jisaac2021/IOPTIS-Laser-Controller-Circuit/README.md

## IOPTIS NEW GEN Laser Controller Circuit

## **PCB Layout 3D View**

**Front**

**Back**



## **Multi-sheet Schematic Layout**



## **Team**
Julia Isaac - Machine Learning & Software Intern

Loic Billaut - Electrical & Optical Engineering Intern
