jisaac2021/IOPTIS-Laser-Controller-Circuit/laser.kicad_pcb

## KiCad design laser.kicad_pcb (2021-09-15)

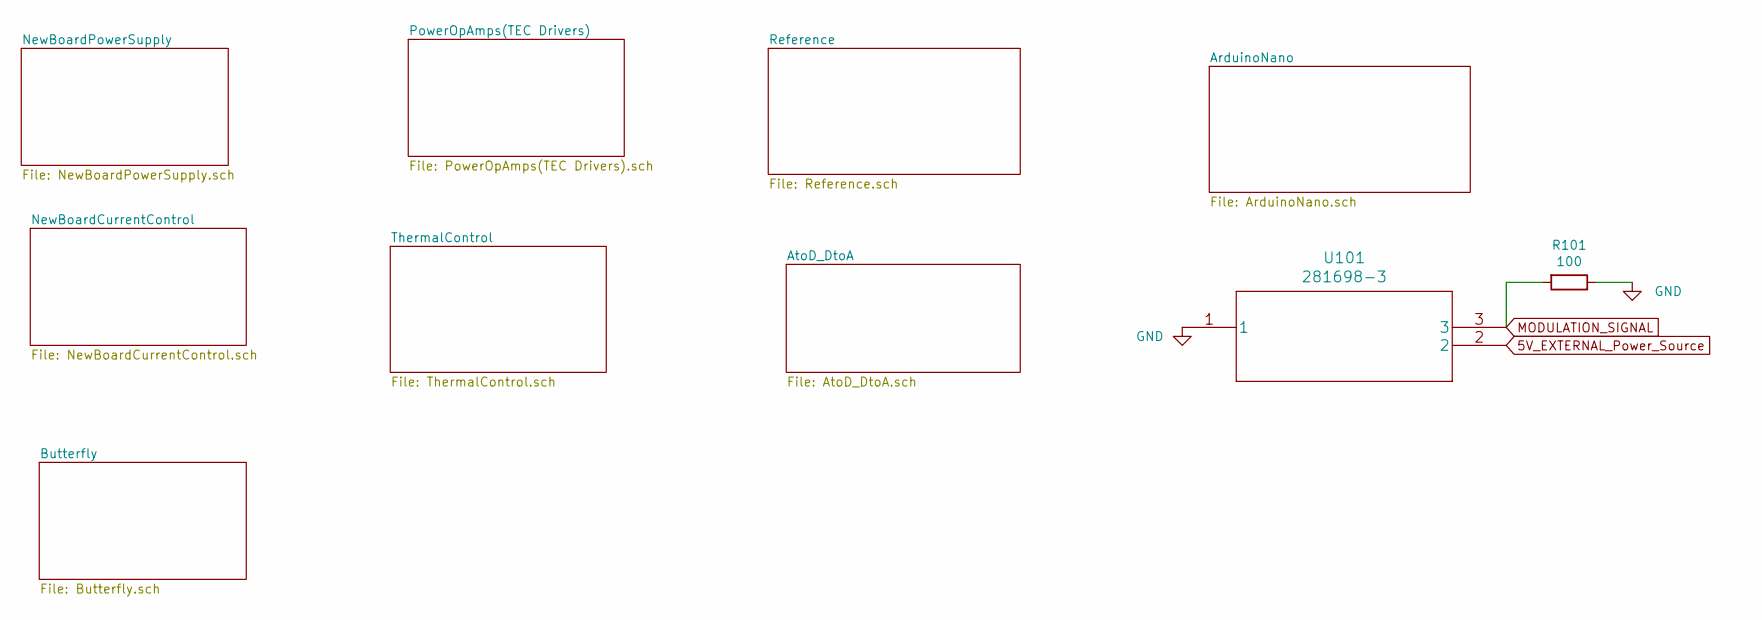
[picture p1: schematic laser.sch]

Parts:
R101: 100; R_0402_1005Metric
U101: 281698-3

Connections:
5V_EXTERNAL_Power_Source: U101.2; also elsewhere on the board
GND: R101.1, U101.1; also elsewhere on the board
MODULATION_SIGNAL: R101.2, U101.3; also elsewhere on the board

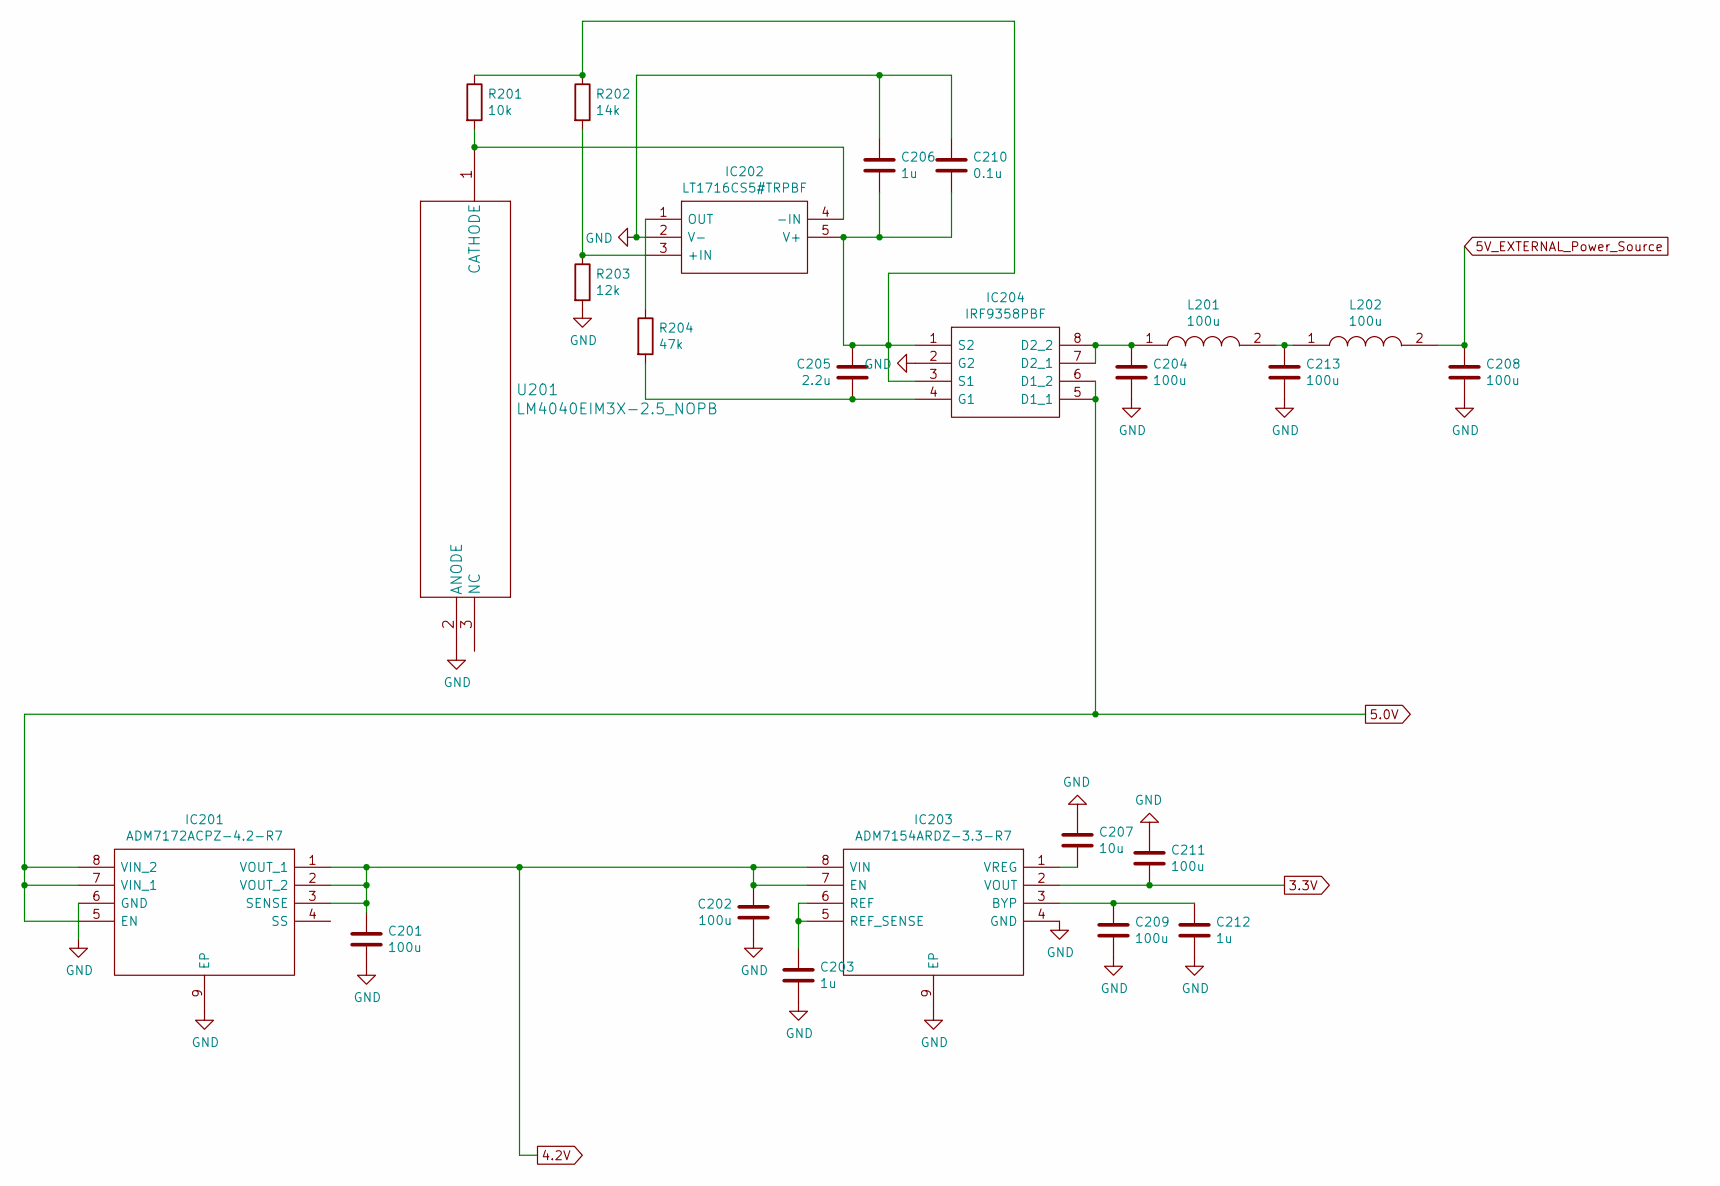
[picture p2: schematic NewBoardPowerSupply.sch]

Parts:
C201, C202, C204, C208, C209, C211, C213: 100u; C_1210_3225Metric
C203, C206, C212: 1u; C_0402_1005Metric
C205: 2.2u; C_0402_1005Metric
C207: 10u; C_0402_1005Metric
C210: 0.1u; C_0402_1005Metric
IC201: ADM7172ACPZ-4.2-R7; Manufacturer_Part_Number ADM7172ACPZ-4.2-R7; Mouser Part Number 584-ADM7172ACPZ4.2R7
IC202: LT1716CS5#TRPBF; Manufacturer_Part_Number LT1716CS5#TRPBF; Mouser Part Number 584-LT1716CS5#TRPBF
IC203: ADM7154ARDZ-3.3-R7; ADA4528-2ACPZ-RL; Manufacturer_Part_Number ADM7154ARDZ-3.3-R7; Mouser Part Number 584-ADM7154ARDZ3.3R7
IC204: IRF9358PBF; Manufacturer_Part_Number IRF9358PBF; Mouser Part Number 942-IRF9358PBF
L201, L202: 100u; 7447714220; Manufacturer_Part_Number 7447714101; Mouser Part Number 710-7447714101
R201: 10k; R_0402_1005Metric
R202: 14k; R_0805_2012Metric
R203: 12k; R_0402_1005Metric
R204: 47k; R_0402_1005Metric
U201: LM4040EIM3X-2.5_NOPB; LM4040EIM3X-2.5&slash_NOPB

Connections:
3.3V: C211.2, IC203.2 (VOUT); also elsewhere on the board
4.2V: C201.1, C202.1, IC201.1 (VOUT_1), IC201.2 (VOUT_2), IC201.3 (SENSE), IC203.7 (EN), IC203.8 (VIN); also elsewhere on the board
5.0V: IC201.5 (EN), IC201.7 (VIN_1), IC201.8 (VIN_2), IC204.5 (D1_1), IC204.6 (D1_2); also elsewhere on the board
5V_EXTERNAL_Power_Source: C208.2, L202.2; also elsewhere on the board
GND: C201.2, C202.2, C203.2, C204.1, C206.1, C207.1, C208.1, C209.2, C210.1, C211.1, C212.2, C213.1, IC201.6 (GND), IC201.9 (EP), IC202.2 (V-), IC203.4 (GND), IC203.9 (EP), IC204.2 (G2), R203.2, U201.2 (ANODE); also elsewhere on the board
unnamed: C203.1, IC203.5 (REF_SENSE), IC203.6 (REF)
unnamed: C204.2, IC204.7 (D2_1), IC204.8 (D2_2), L201.1
unnamed: C205.1, C206.2, C210.2, IC202.5 (V+), IC204.1 (S2), IC204.3 (S1), R201.1, R202.1
unnamed: C205.2, IC204.4 (G1), R204.2
unnamed: C207.2, IC203.1 (VREG)
unnamed: C209.1, C212.1, IC203.3 (BYP)
unnamed: C213.2, L201.2, L202.1
unnamed: IC202.1 (OUT), R204.1
unnamed: IC202.3 (+IN), R202.2, R203.1
unnamed: IC202.4 (-IN), R201.2, U201.1 (CATHODE)

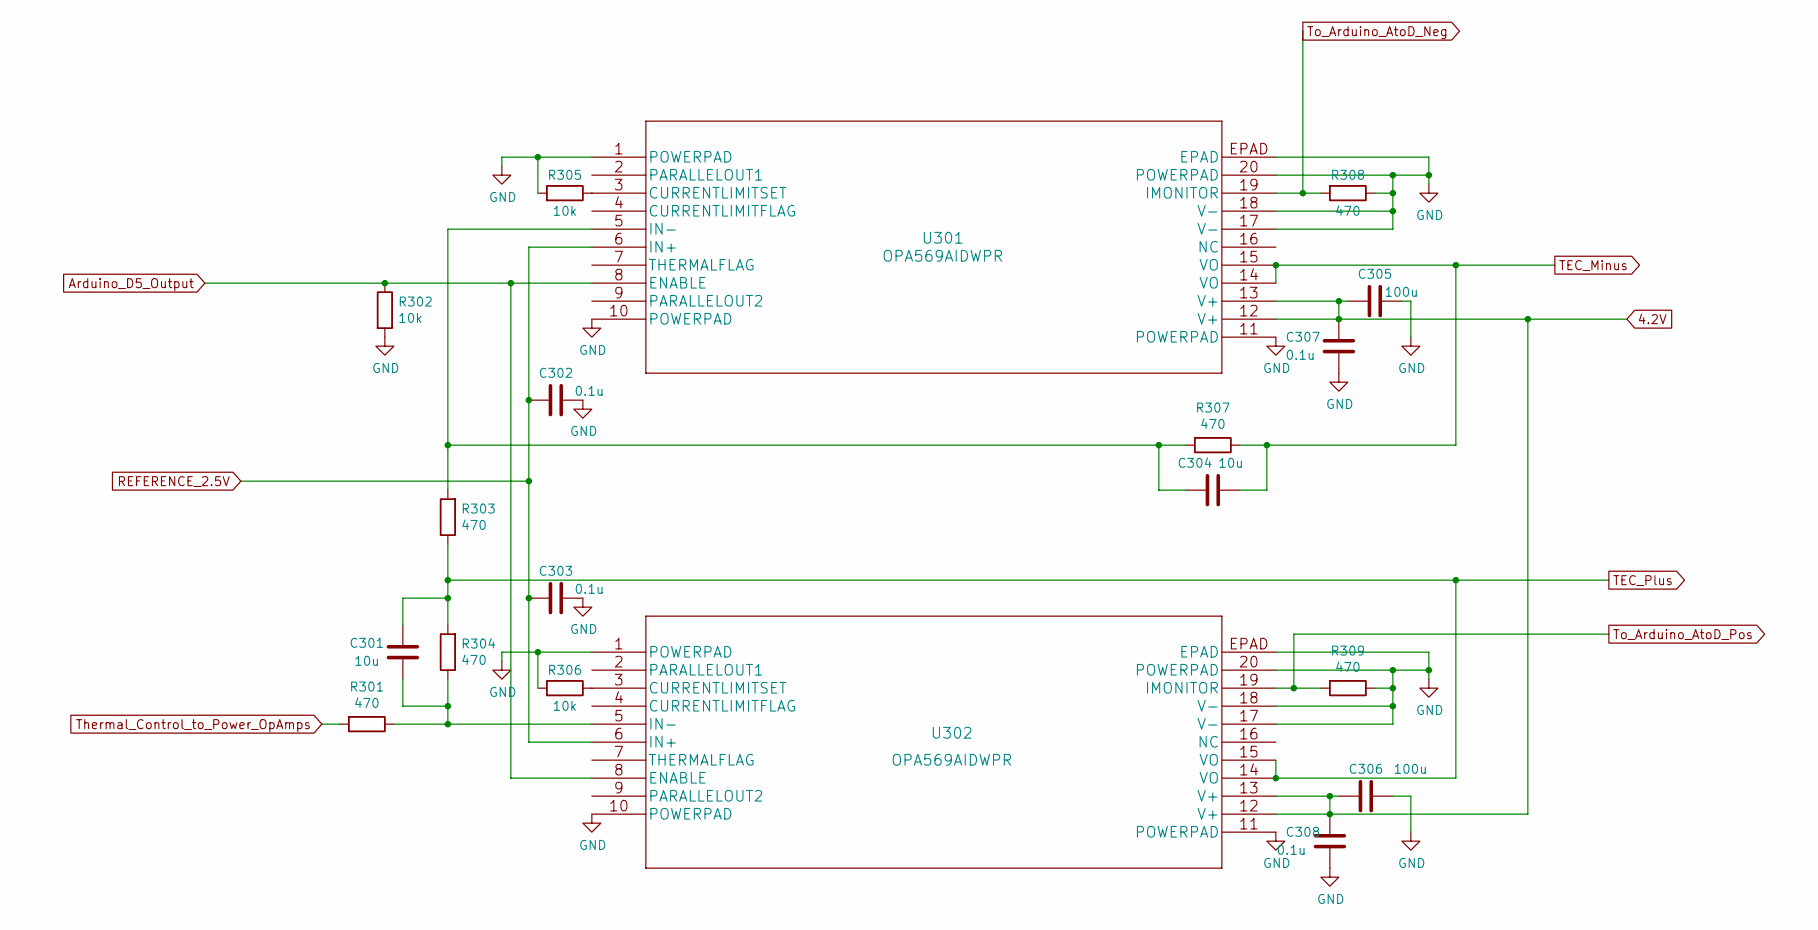
[picture p3: schematic PowerOpAmps(TEC Drivers).sch]

Parts:
C301, C304: 10u; C_0402_1005Metric
C302, C303, C307, C308: 0.1u; C_0402_1005Metric
C305, C306: 100u; C_1210_3225Metric
R301, R303, R304, R307, R308, R309: 470; R_0402_1005Metric
R302, R305, R306: 10k; R_0402_1005Metric
U301, U302: OPA569AIDWPR

Connections:
4.2V: C305.2, C306.2, C307.1, C308.1, U301.12 (V+), U301.13 (V+), U302.12 (V+), U302.13 (V+); also elsewhere on the board
Arduino_D5_Output: R302.1, U301.8 (ENABLE), U302.8 (ENABLE); also elsewhere on the board
GND: C302.1, C303.1, C305.1, C306.1, C307.2, C308.2, R302.2, R305.2, R306.2, R308.1, R309.1, U301.1 (POWERPAD), U301.10 (POWERPAD), U301.11 (POWERPAD), U301.17 (V-), U301.18 (V-), U301.20 (POWERPAD), U301.EPAD, U302.1 (POWERPAD), U302.10 (POWERPAD), U302.11 (POWERPAD), U302.17 (V-), U302.18 (V-), U302.20 (POWERPAD), U302.EPAD; also elsewhere on the board
unnamed: C301.1, R301.1, R304.1, U302.5 (IN-)
unnamed: C304.2, R303.2, R307.2, U301.5 (IN-)
unnamed: R305.1, U301.3 (CURRENTLIMITSET)
unnamed: R306.1, U302.3 (CURRENTLIMITSET)
REFERENCE_2.5V: C302.2, C303.2, U301.6 (IN+), U302.6 (IN+); also elsewhere on the board
TEC_Minus: C304.1, R307.1, U301.14 (VO), U301.15 (VO); also elsewhere on the board
TEC_Plus: C301.2, R303.1, R304.2, U302.14 (VO), U302.15 (VO); also elsewhere on the board
Thermal_Control_to_Power_OpAmps: R301.2; also elsewhere on the board
To_Arduino_AtoD_Neg: R308.2, U301.19 (IMONITOR); also elsewhere on the board
To_Arduino_AtoD_Pos: R309.2, U302.19 (IMONITOR); also elsewhere on the board

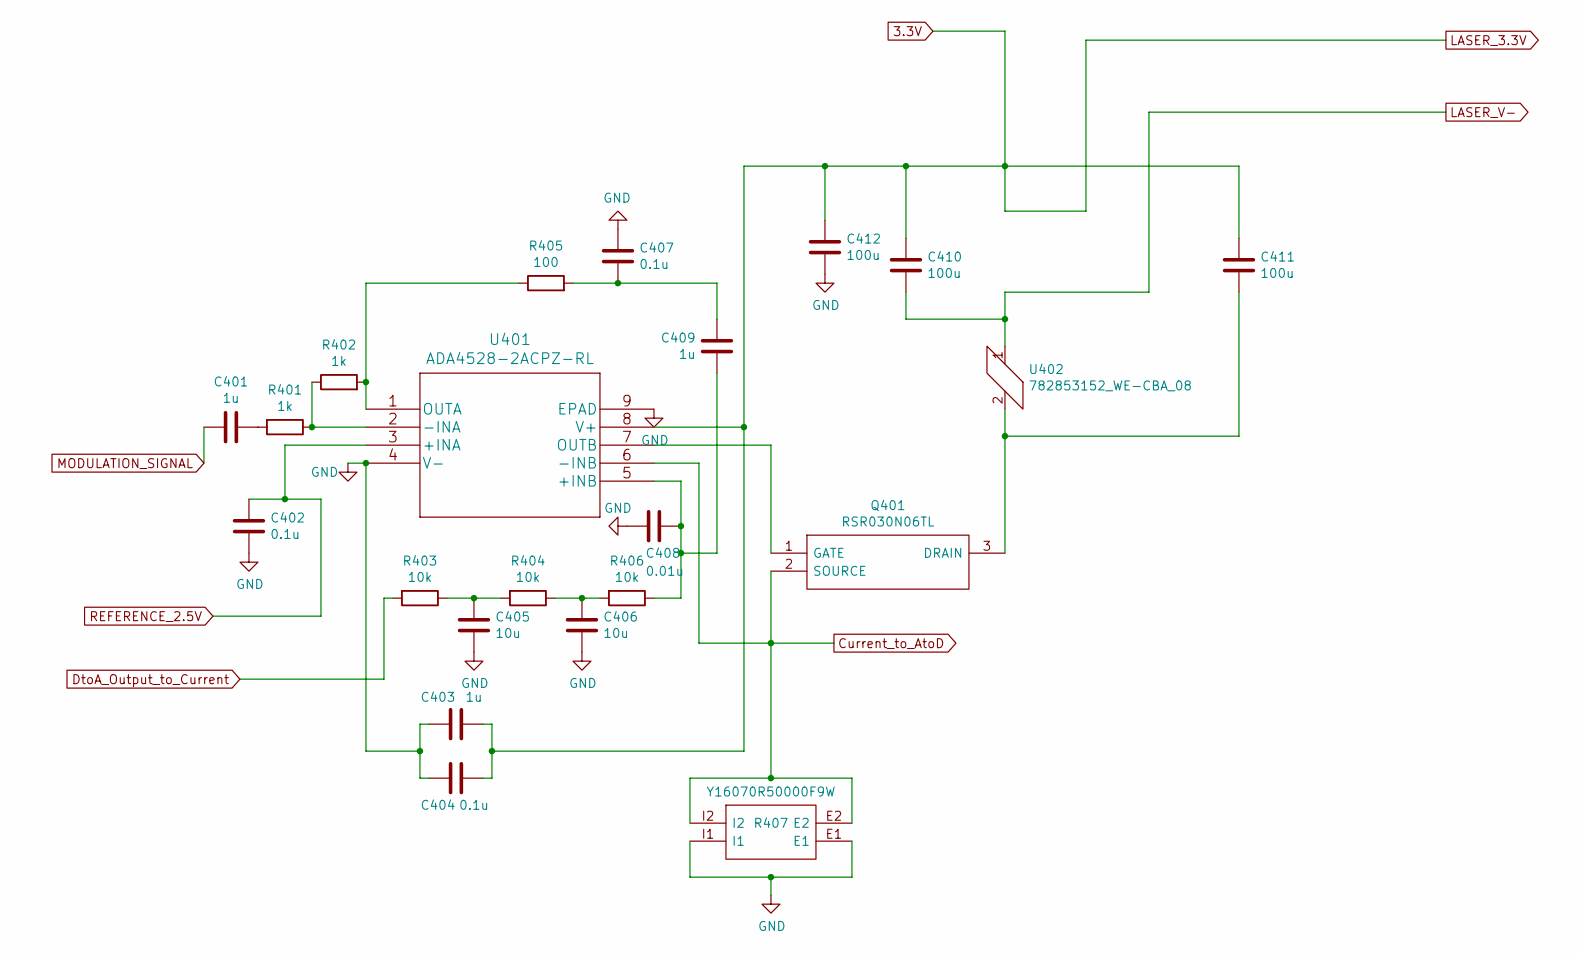
[picture p4: schematic NewBoardCurrentControl.sch]

Parts:
C401, C403, C409: 1u; C_0402_1005Metric
C402, C404, C407: 0.1u; C_0402_1005Metric
C405, C406: 10u; C_0402_1005Metric
C408: 0.01u; C_0402_1005Metric
C410, C411, C412: 100u; C_1210_3225Metric
Q401: RSR030N06TL; Manufacturer_Part_Number RSR030N06TL; Mouser Part Number 755-RSR030N06TL
R401, R402: 1k; R_0402_1005Metric
R403, R404, R406: 10k; R_0603_1608Metric
R405: 100; R_0402_1005Metric
R407: Y16070R50000F9W; Y16072R00000T9W; Manufacturer_Part_Number Y16070R50000F9W; Mouser Part Number 71-VCS1625Z0R5000FSW
U401: ADA4528-2ACPZ-RL
U402: 782853152_WE-CBA_08; 782853121

Connections:
3.3V: C403.1, C404.1, C410.1, C411.1, C412.1, U401.8 (V+); also elsewhere on the board
Current_to_AtoD: Q401.2 (SOURCE), R407.E2, R407.I2, U401.6 (-INB); also elsewhere on the board
DtoA_Output_to_Current: R403.2; also elsewhere on the board
GND: C402.1, C403.2, C404.2, C405.2, C406.2, C407.1, C408.2, C412.2, R407.E1, R407.I1, U401.4 (V-), U401.9 (EPAD); also elsewhere on the board
LASER_V-: C410.2, U402.1; also elsewhere on the board
MODULATION_SIGNAL: C401.2; also elsewhere on the board
unnamed: C401.1, R401.2
unnamed: C405.1, R403.1, R404.2
unnamed: C406.1, R404.1, R406.2
unnamed: C407.2, C409.1, R405.2
unnamed: C408.1, C409.2, R406.1, U401.5 (+INB)
unnamed: C411.2, Q401.3 (DRAIN), U402.2
unnamed: Q401.1 (GATE), U401.7 (OUTB)
unnamed: R401.1, R402.1, U401.2 (-INA)
unnamed: R402.2, R405.1, U401.1 (OUTA)
REFERENCE_2.5V: C402.2, U401.3 (+INA); also elsewhere on the board

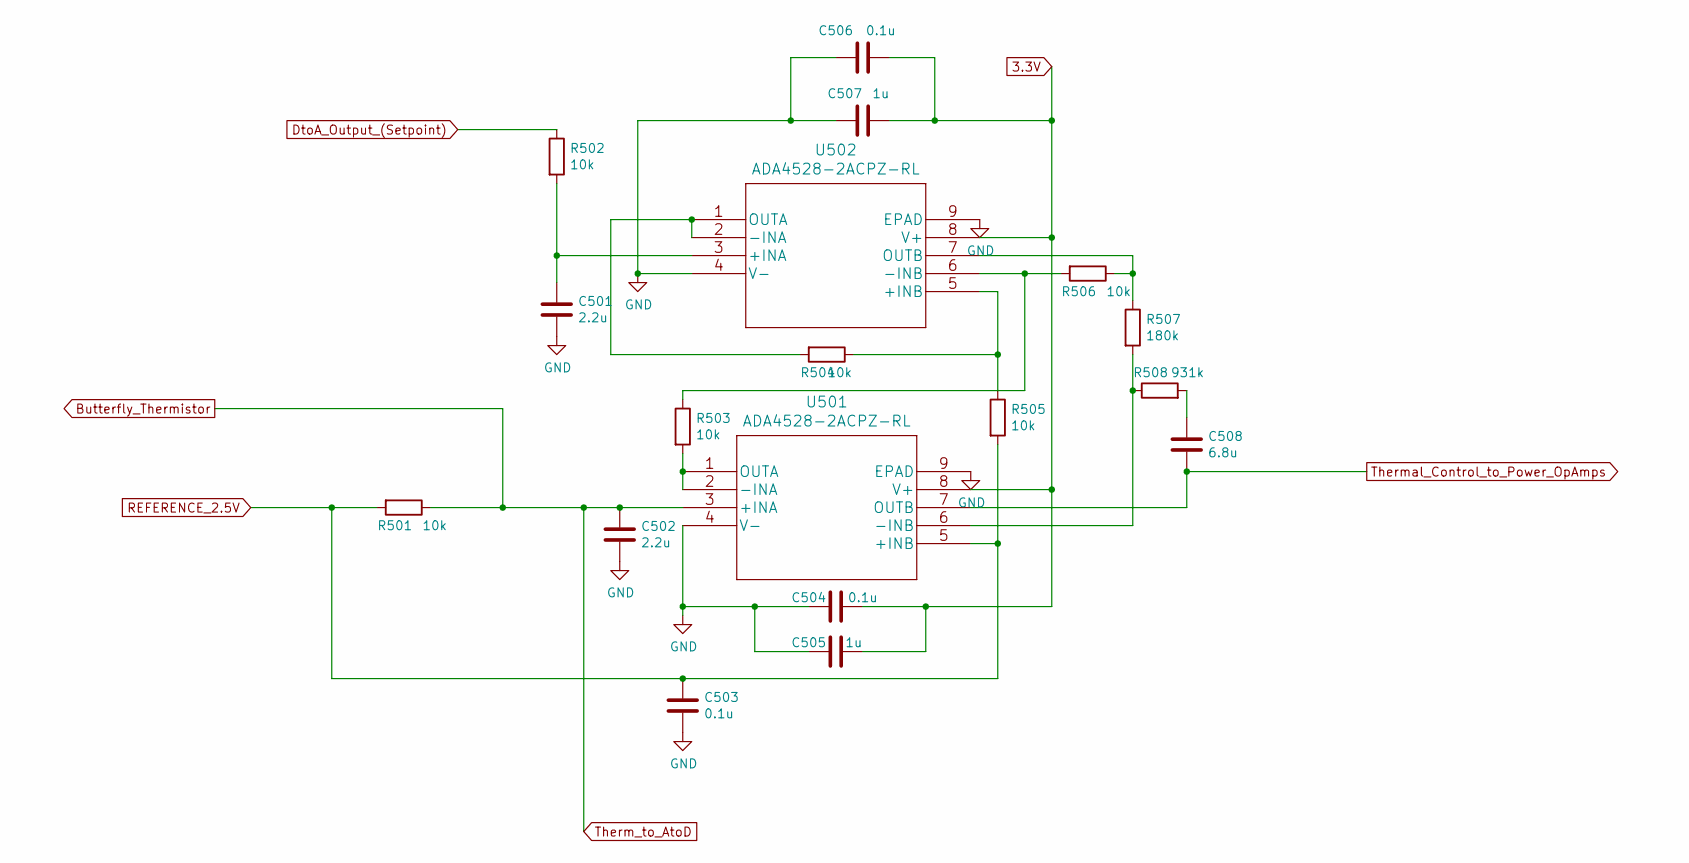
[picture p5: schematic ThermalControl.sch]

Parts:
C501, C502: 2.2u; C_0402_1005Metric
C503, C504, C506: 0.1u; C_0402_1005Metric
C505, C507: 1u; C_0402_1005Metric
C508: 6.8u; C_1812_4532Metric
R501, R502, R503, R504, R505, R506: 10k; R_0603_1608Metric
R507: 180k; R_0603_1608Metric
R508: 931k; R_0805_2012Metric
U501, U502: ADA4528-2ACPZ-RL

Connections:
3.3V: C504.1, C505.1, C506.1, C507.1, U501.8 (V+), U502.8 (V+); also elsewhere on the board
Butterfly_Thermistor: C502.1, R501.1, U501.3 (+INA); also elsewhere on the board
DtoA_Output_(Setpoint): R502.1; also elsewhere on the board
GND: C501.2, C502.2, C503.2, C504.2, C505.2, C506.2, C507.2, U501.4 (V-), U501.9 (EPAD), U502.4 (V-), U502.9 (EPAD); also elsewhere on the board
unnamed: C501.1, R502.2, U502.3 (+INA)
unnamed: C508.1, R508.2
unnamed: R503.1, R506.2, U502.6 (-INB)
unnamed: R503.2, U501.1 (OUTA), U501.2 (-INA)
unnamed: R504.1, R505.1, U502.5 (+INB)
unnamed: R504.2, U502.1 (OUTA), U502.2 (-INA)
unnamed: R506.1, R507.1, U502.7 (OUTB)
unnamed: R507.2, R508.1, U501.6 (-INB)
REFERENCE_2.5V: C503.1, R501.2, R505.2, U501.5 (+INB); also elsewhere on the board
Thermal_Control_to_Power_OpAmps: C508.2, U501.7 (OUTB); also elsewhere on the board

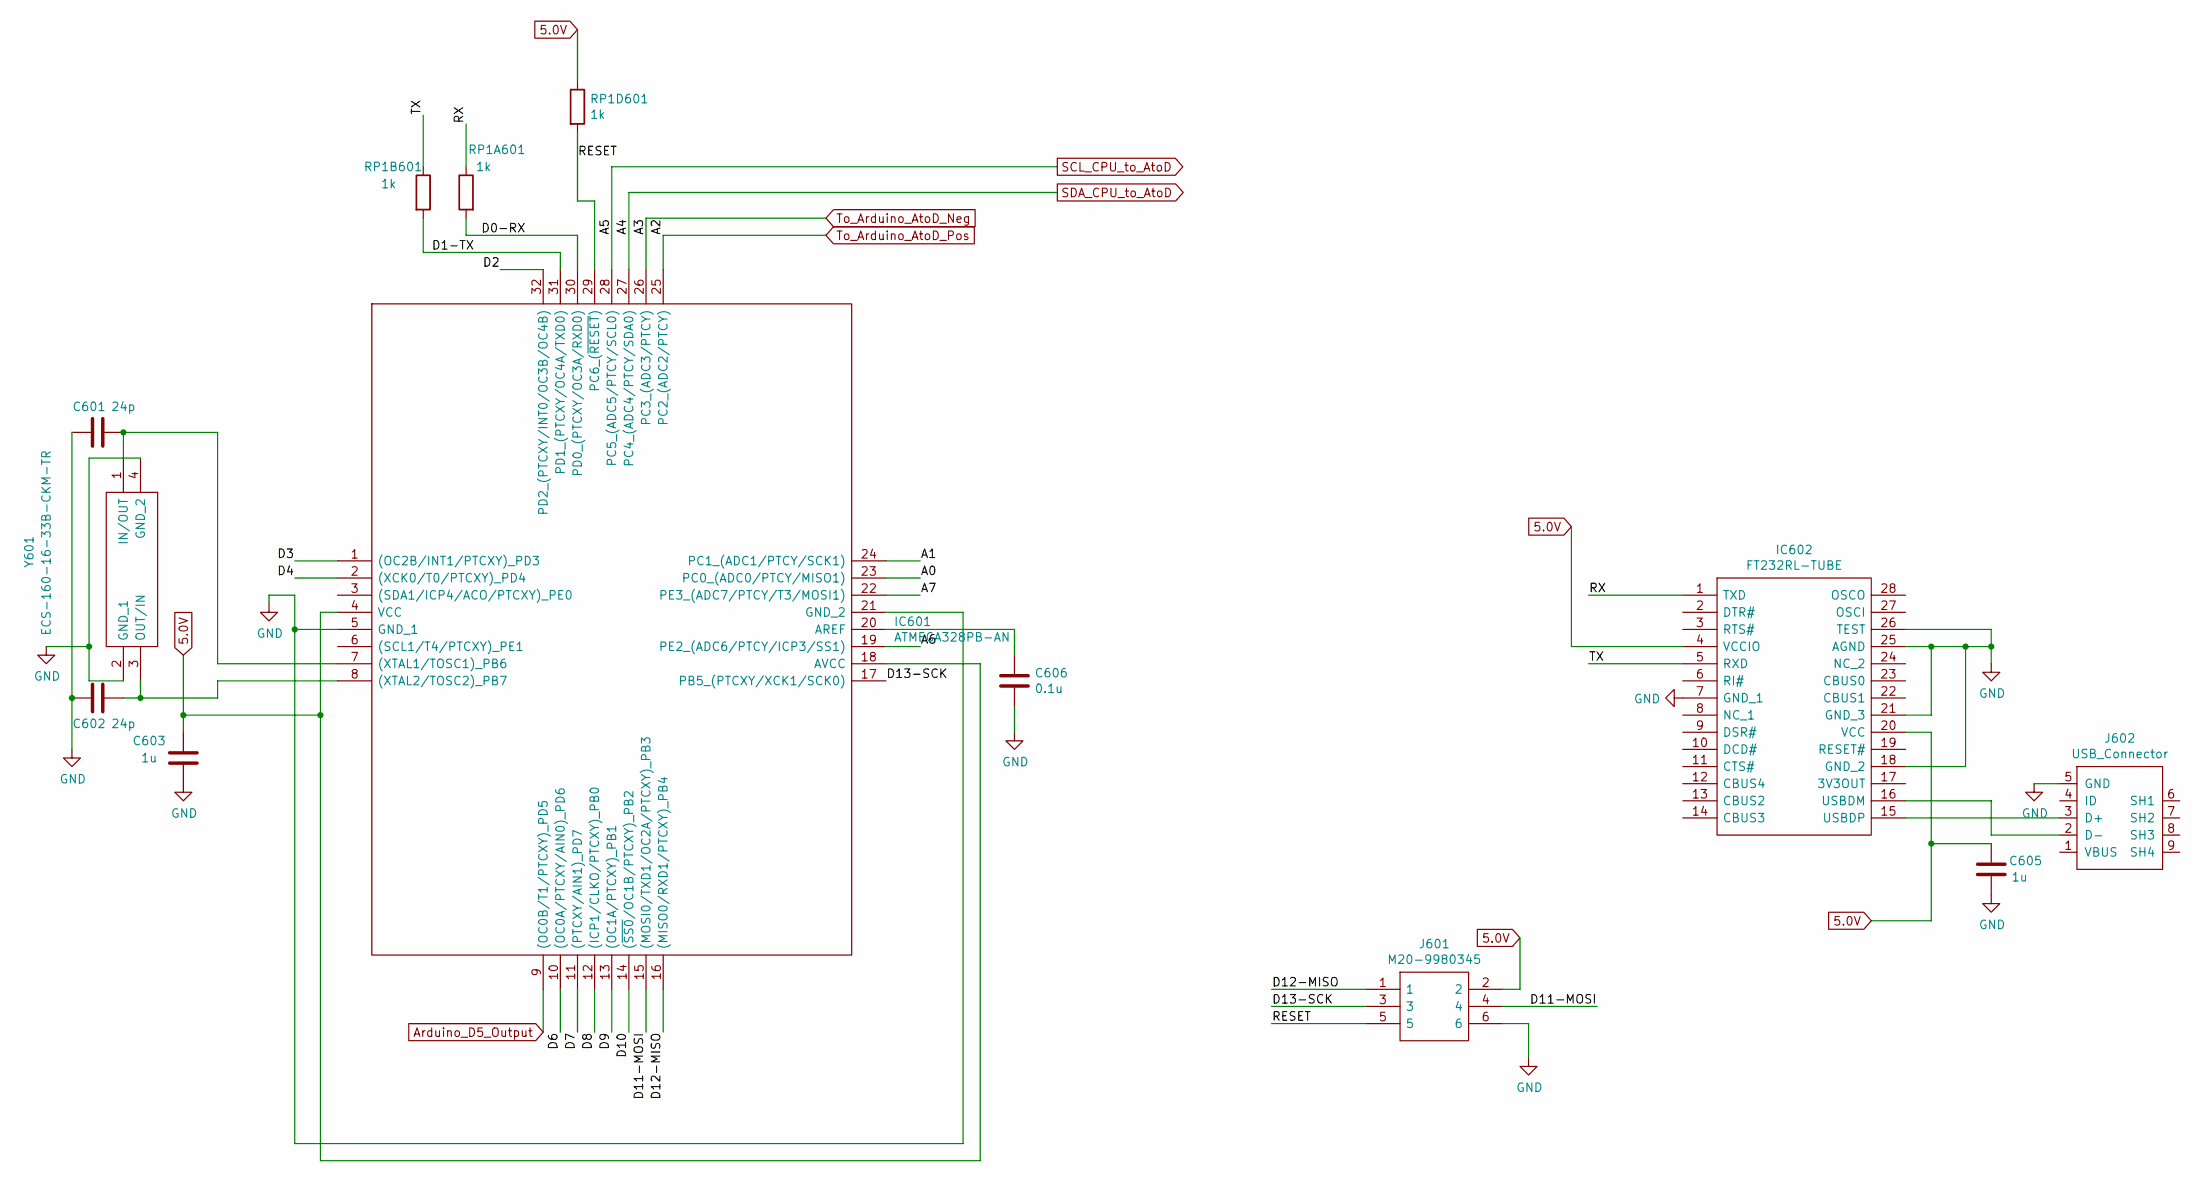
[picture p6: schematic ArduinoNano.sch]

Parts:
C601, C602: 24p; C_0402_1005Metric
C603, C605: 1u; C_0402_1005Metric
C606: 0.1u; C_0402_1005Metric
IC601: ATMEGA328PB-AN; QFP80P900X900X120-32N; Mouser Part Number 556-ATMEGA328PB-AN
IC602: FT232RL-TUBE; Manufacturer_Part_Number FT232RL-TUBE; Mouser Part Number 895-FT232RL-TUBE
J601: M20-9980345; Manufacturer_Part_Number M20-9980345; Mouser Part Number 855-M20-9980345
J602: USB_Connector; CUI_UJ2-MBH-1-SMT
RP1A601, RP1B601, RP1D601: 1k; R_0402_1005Metric
Y601: ECS-160-16-33B-CKM-TR; ECS1601633BCKMTR; Mouser Part Number 520-160-16-33B-CKMTR

Connections:
5.0V: C603.1, C605.1, IC601.4 (VCC), IC601.18 (AVCC), IC602.4 (VCCIO), IC602.20 (VCC), J601.2, RP1D601.1; also elsewhere on the board
/ArduinoNano/A0: IC601.23 (PC0_(ADC0/PTCY/MISO1))
/ArduinoNano/A1: IC601.24 (PC1_(ADC1/PTCY/SCK1))
/ArduinoNano/A6: IC601.19 (PE2_(ADC6/PTCY/ICP3/SS1))
/ArduinoNano/A7: IC601.22 (PE3_(ADC7/PTCY/T3/MOSI1))
/ArduinoNano/D0-RX: IC601.30 (PD0_(PTCXY/OC3A/RXD0)), RP1A601.2
/ArduinoNano/D1-TX: IC601.31 (PD1_(PTCXY/OC4A/TXD0)), RP1B601.2
/ArduinoNano/D2: IC601.32 (PD2_(PTCXY/INT0/OC3B/OC4B))
/ArduinoNano/D3: IC601.1 ((OC2B/INT1/PTCXY)_PD3)
/ArduinoNano/D4: IC601.2 ((XCK0/T0/PTCXY)_PD4)
/ArduinoNano/D6: IC601.10 ((OC0A/PTCXY/AIN0)_PD6)
/ArduinoNano/D7: IC601.11 ((PTCXY/AIN1)_PD7)
/ArduinoNano/D8: IC601.12 ((ICP1/CLKO/PTCXY)_PB0)
/ArduinoNano/D9: IC601.13 ((OC1A/PTCXY)_PB1)
/ArduinoNano/D10: IC601.14 ((~SS0~/OC1B/PTCXY)_PB2)
/ArduinoNano/D11-MOSI: IC601.15 ((MOSI0/TXD1/OC2A/PTCXY)_PB3), J601.4
/ArduinoNano/D12-MISO: IC601.16 ((MISO0/RXD1/PTCXY)_PB4), J601.1
/ArduinoNano/D13-SCK: IC601.17 (PB5_(PTCXY/XCK1/SCK0)), J601.3
/ArduinoNano/RESET: IC601.29 (PC6_(~RESET)), J601.5, RP1D601.2
/ArduinoNano/RX: IC602.1 (TXD), RP1A601.1
/ArduinoNano/TX: IC602.5 (RXD), RP1B601.1
Arduino_D5_Output: IC601.9 ((OC0B/T1/PTCXY)_PD5); also elsewhere on the board
GND: C601.2, C602.2, C603.2, C605.2, C606.2, IC601.5 (GND_1), IC601.21 (GND_2), IC602.7 (GND_1), IC602.18 (GND_2), IC602.21 (GND_3), IC602.25 (AGND), IC602.26 (TEST), J601.6, J602.5 (GND), Y601.2 (GND_1), Y601.4 (GND_2); also elsewhere on the board
unnamed: C601.1, IC601.7 ((XTAL1/TOSC1)_PB6), Y601.1 (IN/OUT)
unnamed: C602.1, IC601.8 ((XTAL2/TOSC2)_PB7), Y601.3 (OUT/IN)
unnamed: C606.1, IC601.20 (AREF)
unnamed: IC602.15 (USBDP), J602.3 (D+)
unnamed: IC602.16 (USBDM), J602.2 (D-)
SCL_CPU_to_AtoD: IC601.28 (PC5_(ADC5/PTCY/SCL0)); also elsewhere on the board
SDA_CPU_to_AtoD: IC601.27 (PC4_(ADC4/PTCY/SDA0)); also elsewhere on the board
To_Arduino_AtoD_Neg: IC601.26 (PC3_(ADC3/PTCY)); also elsewhere on the board
To_Arduino_AtoD_Pos: IC601.25 (PC2_(ADC2/PTCY)); also elsewhere on the board

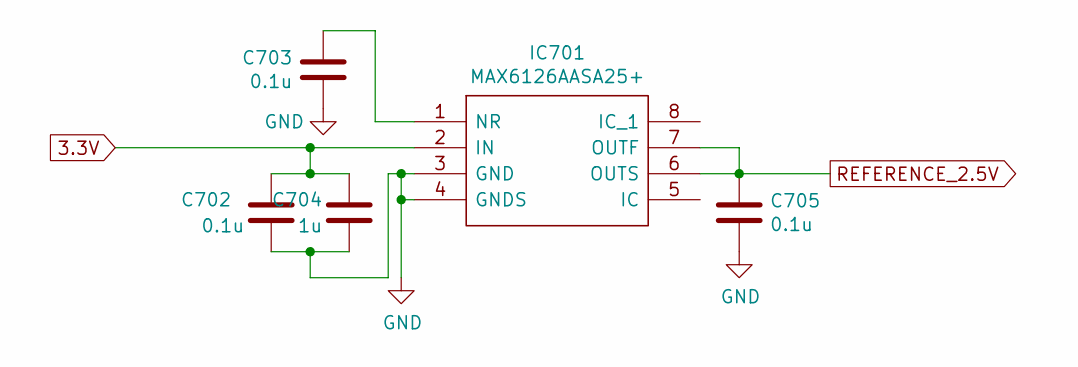
[picture p7: schematic Reference.sch]

Parts:
C702, C703, C705: 0.1u; C_0402_1005Metric
C704: 1u; C_0402_1005Metric
IC701: MAX6126AASA25+; MAX6126-25+; Manufacturer_Part_Number MAX6126AASA25+; Mouser Part Number 700-MAX6126AASA25

Connections:
3.3V: C702.1, C704.1, IC701.2 (IN); also elsewhere on the board
GND: C702.2, C703.2, C704.2, C705.2, IC701.3 (GND), IC701.4 (GNDS); also elsewhere on the board
unnamed: C703.1, IC701.1 (NR)
REFERENCE_2.5V: C705.1, IC701.6 (OUTS), IC701.7 (OUTF); also elsewhere on the board

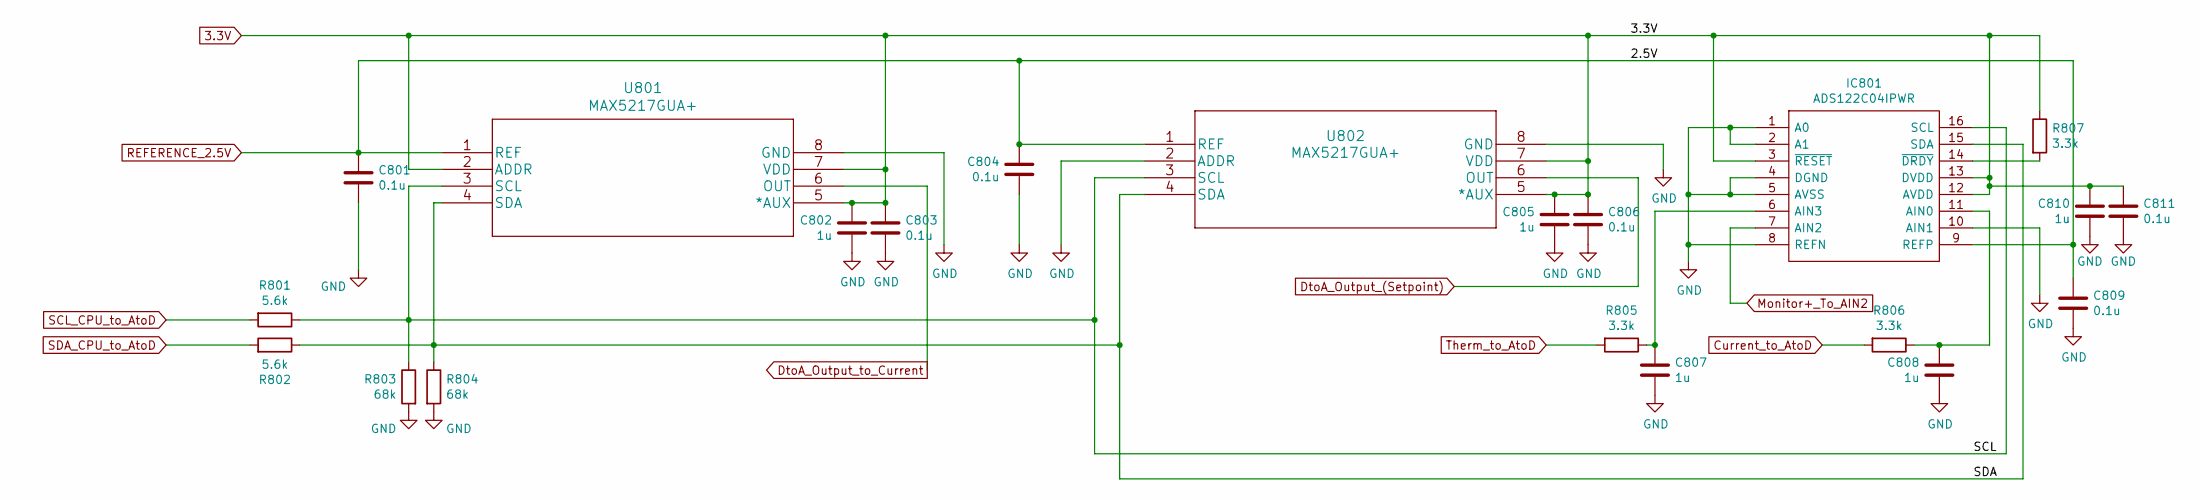
[picture p8: schematic AtoD_DtoA.sch]

Parts:
C801, C803, C804, C806, C809, C811: 0.1u; C_0402_1005Metric
C802, C805, C807, C808, C810: 1u; C_0402_1005Metric
IC801: ADS122C04IPWR; Manufacturer_Part_Number ADS122C04IPWR; Mouser Part Number 595-ADS122C04IPWR
R801, R802: 5.6k; R_0402_1005Metric
R803, R804: 68k; R_0402_1005Metric
R805, R806, R807: 3.3k; R_0402_1005Metric
U801, U802: MAX5217GUA+; MAX5217GUA&plus_

Connections:
3.3V: C802.1, C803.1, C805.1, C806.1, C810.1, C811.1, IC801.3 (~RESET), IC801.12 (AVDD), IC801.13 (DVDD), R807.1, U801.2 (ADDR), U801.5 (*AUX), U801.7 (VDD), U802.5 (*AUX), U802.7 (VDD); also elsewhere on the board
/AtoD_DtoA/SCL: IC801.16 (SCL), R801.1, R803.1, U801.3 (SCL), U802.3 (SCL)
/AtoD_DtoA/SDA: IC801.15 (SDA), R802.1, R804.1, U801.4 (SDA), U802.4 (SDA)
Butterfly_Thermistor: R805.2; also elsewhere on the board
Current_to_AtoD: R806.2; also elsewhere on the board
DtoA_Output_(Setpoint): U802.6 (OUT); also elsewhere on the board
DtoA_Output_to_Current: U801.6 (OUT); also elsewhere on the board
GND: C801.2, C802.2, C803.2, C804.2, C805.2, C806.2, C807.2, C808.2, C809.2, C810.2, C811.2, IC801.1 (A0), IC801.2 (A1), IC801.4 (DGND), IC801.5 (AVSS), IC801.8 (REFN), IC801.10 (AIN1), R803.2, R804.2, U801.8 (GND), U802.2 (ADDR), U802.8 (GND); also elsewhere on the board
Monitor+_To_AIN2: IC801.7 (AIN2); also elsewhere on the board
unnamed: C807.1, IC801.6 (AIN3), R805.1
unnamed: C808.1, IC801.11 (AIN0), R806.1
unnamed: IC801.14 (~DRDY), R807.2
REFERENCE_2.5V: C801.1, C804.1, C809.1, IC801.9 (REFP), U801.1 (REF), U802.1 (REF); also elsewhere on the board
SCL_CPU_to_AtoD: R801.2; also elsewhere on the board
SDA_CPU_to_AtoD: R802.2; also elsewhere on the board

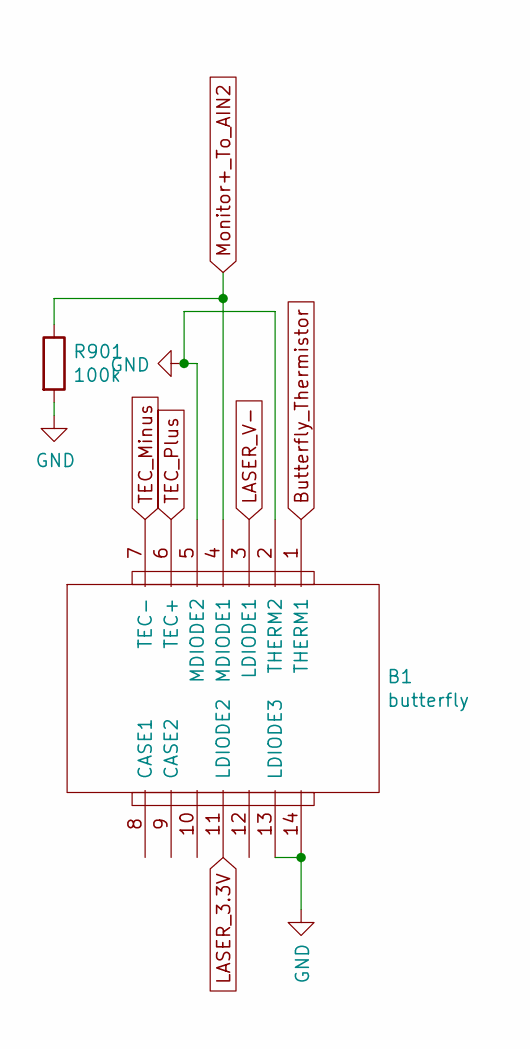
[picture p9: schematic Butterfly.sch]

Parts:
B1: butterfly; Butterfly
R901: 100k; R_0402_1005Metric

Connections:
3.3V: B1.11 (LDIODE2); also elsewhere on the board
Butterfly_Thermistor: B1.1 (THERM1); also elsewhere on the board
GND: B1.2 (THERM2), B1.5 (MDIODE2), B1.13 (LDIODE3), B1.14, R901.2; also elsewhere on the board
LASER_V-: B1.3 (LDIODE1); also elsewhere on the board
Monitor+_To_AIN2: B1.4 (MDIODE1), R901.1; also elsewhere on the board
TEC_Minus: B1.7 (TEC-); also elsewhere on the board
TEC_Plus: B1.6 (TEC+); also elsewhere on the board

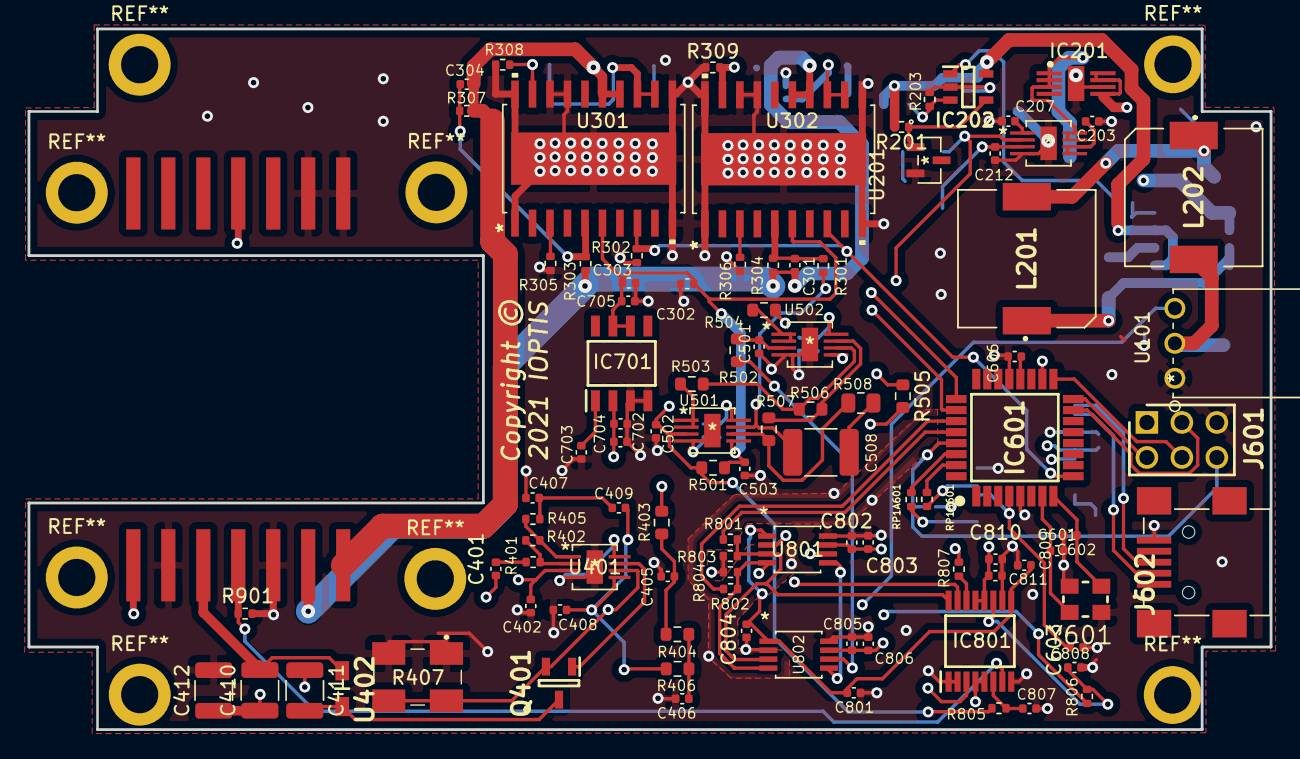
[picture p10: board laser.kicad_pcb from above]

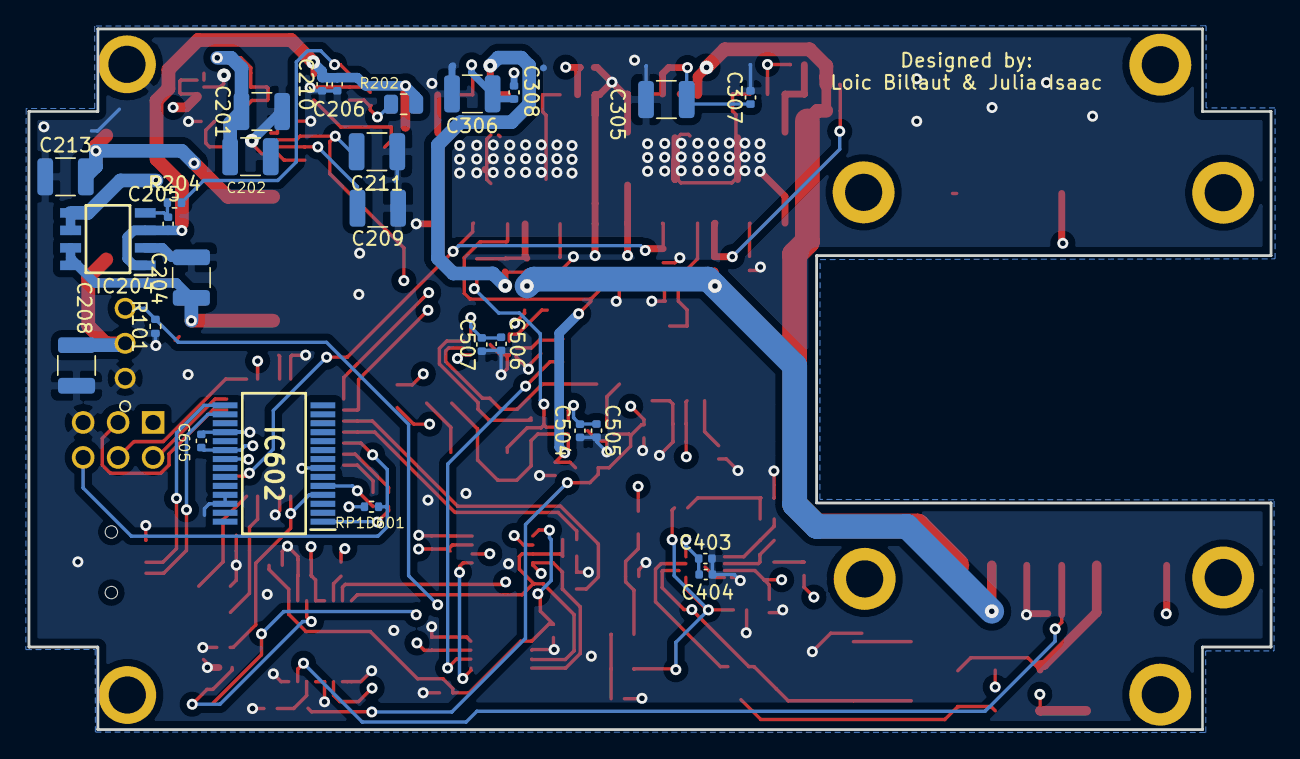
[picture p11: board laser.kicad_pcb from below]

Board: 4 copper layers, 90.2 x 50.9 mm, 126 parts (27 on the bottom side), 71 nets.
