jisaac2021/IOPTIS-Laser-Controller-Circuit/(commit log)

2021-06-09 Setup subsheets
    [NewBoardCurrentControl.sch, NewBoardPowerSupply.sch, PowerOpAmps(TEC Drivers).sch, ThermalControl.sch, laser.kicad_pcb, laser.sch]
2021-06-09 third commit
    [NewBoardCurrentControl.sch, NewBoardPowerSupply.sch, PowerOpAmps(TEC Drivers).sch, ThermalControl.sch, laser.sch]
2021-06-09 add ADM7172ACPZ-4.2-R7 library
    [NewBoardCurrentControl.sch, NewBoardPowerSupply.sch, PowerOpAmps(TEC Drivers).sch, ThermalControl.sch, laser.sch]
2021-06-09 add ADM7154ARDZ-3.3-R7 library
    [NewBoardPowerSupply.sch]
2021-06-09 added mosfet
    [NewBoardPowerSupply.sch, ThermalControl.sch]
2021-06-09 add LM4040
    [NewBoardPowerSupply.sch]
2021-06-09 catching up
    [ThermalControl.sch]
2021-06-09 remove laser rescue
2021-06-09 recover symbols
    [ThermalControl.sch]
2021-06-09 getting libraries to work
    [NewBoardPowerSupply.sch, ThermalControl.sch, laser-cache.sch]
2021-06-10 finished the thermal control schematic?
2021-06-10 forgot to save before doing the last one LOL
    [ThermalControl.sch]
2021-06-11 add LT1716
    [NewBoardPowerSupply.sch]
2021-06-12 finished thermal control on friday
    [4.2VRegulator.kicad_pcb, 4.2VRegulator.sch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]
2021-06-14 put capacitors b/w gnd and power
    [ThermalControl.sch]
2021-06-14 added labels for loose ends
    [NewBoardPowerSupply.sch, PowerOpAmps(TEC Drivers).sch, ThermalControl.sch]
2021-06-14 working on second circuit
    [PowerOpAmps(TEC Drivers).sch]
2021-06-14 finish power supply schematic
    [NewBoardPowerSupply.sch]
2021-06-14 push final edits so i can clone
    [NewBoardPowerSupply.sch, PowerOpAmps(TEC Drivers) spare.sch, ThermalControlSpare.sch]
2021-06-14 added newBoardPowerSupply to the folder
    [NewBoardPowerSupply.sch]
2021-06-14 grounded GND pin on 4.2V regulator
    [NewBoardPowerSupply.sch, ThermalControlSpare.sch]
2021-06-14 unconnect R3 and R5 to ground
    [NewBoardPowerSupply.sch]
2021-06-14 powerOpAmpBoard ready for QA
    [NewBoardCurrentControl.sch, PowerOpAmps(TEC Drivers).sch]
2021-06-15 added capacitors on power op amp schematic
    [NewBoardPowerSupply.sch, PowerOpAmps(TEC Drivers).sch, ThermalControl.sch]
2021-06-15 finish current control schematic
    [NewBoardCurrentControl.sch]
2021-06-15 add tiny sch
    [Tiny.sch, laser.sch]
2021-06-15 added HUUGE and max library
    [HUUGE.sch, NewBoardCurrentControl.sch, NewBoardPowerSupply.sch, PowerOpAmps(TEC Drivers).sch, ThermalControl.sch, laser.sch]
2021-06-15 finish tiny sch
    [Tiny.sch]
2021-06-15 added new ferrite bead symbol & footprint to library
    [NewBoardCurrentControl.sch, Tiny.sch]
2021-06-15 add MAX and ADS
    [HUUGE.sch]
2021-06-15 started on nano sheet
    [ArduinoNano.sch, HUUGE.sch, NewBoardCurrentControl.sch, NewBoardPowerSupply.sch, PowerOpAmps(TEC Drivers).sch, ThermalControl.sch, Tiny.sch, laser.sch]
2021-06-15 QA'd, added 2 caps, noted where laser should be
    [NewBoardCurrentControl.sch]
2021-06-15 finish big sch + add appropriate labels
    [HUUGE.sch]
2021-06-15 added 4.2V port from pwr supply to pwr op amps sheet
    [NewBoardPowerSupply.sch, PowerOpAmps(TEC Drivers).sch, laser.sch]
2021-06-15 add resistors to both chips
    [PowerOpAmps(TEC Drivers).sch]
2021-06-15 finish QA - Julia
    [PowerOpAmps(TEC Drivers).sch]
2021-06-15 committing everything
    [ArduinoNano.sch, HUUGE.sch, PowerOpAmps(TEC Drivers).sch, Tiny.sch]
2021-06-15 deleted bad usb port thing
    [ArduinoNano.sch]
2021-06-15 add FT
    [ArduinoNano.sch]
2021-06-15 committing before pulling
    [PowerOpAmps(TEC Drivers).sch]
2021-06-15 start wiring FT
    [ArduinoNano.sch, PowerOpAmps(TEC Drivers).sch]
2021-06-15 space labels
    [PowerOpAmps(TEC Drivers).sch]
2021-06-15 committed changes before pull
    [ArduinoNano.sch, PowerOpAmps(TEC Drivers).sch]
2021-06-15 reload FT
    [ArduinoNano.sch]
2021-06-15 added usb connector
    [ArduinoNano.sch]
2021-06-16 Revert "nano"
    This reverts commit 4d6fd5897fac472e79c13fb1ab6d35398c5daa14, reversing
    changes made to 8aae38f125b68b2cd7fe44fff7f0dd0a54c9a2a8.
    [ArduinoNano.sch]
2021-06-16 flipped connector and grounded
    [ArduinoNano.sch]
2021-06-16 just deleted reset on nano chip
    [ArduinoNano.sch]
2021-06-16 finish USB IC1
    [ArduinoNano.sch]
2021-06-16 add M20 + finish
    [ArduinoNano.sch]
2021-06-16 annotate all sheets
    [ArduinoNano.sch, HUUGE.sch, NewBoardCurrentControl.sch, NewBoardPowerSupply.sch, PowerOpAmps(TEC Drivers).sch, ThermalControl.sch, Tiny.sch]
2021-06-16 reset annotations for tiny, huuge, nano; moved some refs in nano
    [ArduinoNano.sch, Tiny.sch]
2021-06-16 finalized nano (references, one more resistor...)
    [ArduinoNano.sch]
2021-06-16 added new kicad_mod libs to footprint libraries
    [Tiny.sch]
2021-06-16 add footprints
2021-06-16 add footprints julia
    [ArduinoNano.sch, HUUGE.sch, NewBoardCurrentControl.sch, NewBoardPowerSupply.sch, ThermalControl.sch, Tiny.sch]
2021-06-16 added irf footprint
2021-06-16 add footprints 2 julia
    [ArduinoNano.sch, PowerOpAmps(TEC Drivers).sch]
2021-06-16 assigned irf footprint
    [NewBoardPowerSupply.sch]
2021-06-16 added vishay dude & capacitor & resistor footprints
    [ArduinoNano.sch, HUUGE.sch, NewBoardCurrentControl.sch, NewBoardPowerSupply.sch, PowerOpAmps(TEC Drivers).sch, ThermalControl.sch, Tiny.sch]
2021-06-16 changed all 'odd' resistors in thermal control footprints
    [NewBoardCurrentControl.sch, ThermalControl.sch]
2021-06-16 fix spacing
    [ThermalControl.sch]
2021-06-16 added osciallator libs
    [ArduinoNano.sch]
2021-06-16 replace crystal
    [ArduinoNano.sch]
2021-06-16 add coil
    [NewBoardPowerSupply.sch]
2021-06-17 replaced thermistor w/ butterfly
    [ThermalControl.sch]
2021-06-17 changes on nano and laser
    [NewBoardCurrentControl.sch]
2021-06-17 added 3 pin header
2021-06-17 mod signal
    [NewBoardCurrentControl.sch]
2021-06-17 revise AtoD
    [NewBoardCurrentControl.sch]
2021-06-17 add 5V label
    [ArduinoNano.sch]
2021-06-17 added 5v power source 'ports'
    [NewBoardPowerSupply.sch, laser.sch]
2021-06-17 connect 5V label from nano on main
    [laser.sch]
2021-06-17 added some more ports
    [ArduinoNano.sch]
2021-06-17 add mod symbol
    [NewBoardCurrentControl.sch, laser.sch]
2021-06-17 adding 'ports'
    [laser.sch]
2021-06-17 add final 5v connector
    [ArduinoNano.sch]
2021-06-17 pushing other ports
    [NewBoardPowerSupply.sch, laser.sch]
2021-06-17 added other ports
    [ArduinoNano.sch, NewBoardPowerSupply.sch, laser.sch]
2021-06-17 added more ports
    [NewBoardCurrentControl.sch, NewBoardPowerSupply.sch, PowerOpAmps(TEC Drivers).sch, ThermalControl.sch, laser.sch]
2021-06-17 pushing all changes and ports
    [ArduinoNano.sch, HUUGE.sch, NewBoardPowerSupply.sch, PowerOpAmps(TEC Drivers).sch, ThermalControl.sch, Tiny.sch, laser.sch]
2021-06-17 keep on adding global labels
    [HUUGE.sch, ThermalControl.sch]
2021-06-17 name changes
    [AtoD_DtoA.sch, Reference.sch]
2021-06-17 name change on main for sheets
    [AtoD_DtoA.sch, Reference.sch, laser.sch]
2021-06-17 adding labels
    [HUUGE.sch, NewBoardCurrentControl.sch]
2021-06-17 replace heirarchal w/ global
    [NewBoardCurrentControl.sch, NewBoardPowerSupply.sch, Reference.sch, laser.sch]
2021-06-17 commit changes
    [HUUGE.sch, Tiny.sch, laser.sch]
2021-06-17 redo annotations
    [ArduinoNano.sch, AtoD_DtoA.sch, HUUGE.sch, NewBoardCurrentControl.sch, Reference.sch, ThermalControl.sch, Tiny.sch, laser.sch]
2021-06-17 remove excess wires
    [laser.sch]
2021-06-17 add thermal control output
    [ArduinoNano.sch, PowerOpAmps(TEC Drivers).sch]
2021-06-17 did current control
    [ArduinoNano.sch, NewBoardCurrentControl.sch, NewBoardPowerSupply.sch, ThermalControl.sch]
2021-06-17 adding some more labels
    [ArduinoNano.sch, NewBoardCurrentControl.sch, PowerOpAmps(TEC Drivers).sch, ThermalControl.sch]
2021-06-18 FINISHED nano, power op amps
    [ArduinoNano.sch]
2021-06-18 made butterfly a global label, connected SDA & SCL
    [ArduinoNano.sch, AtoD_DtoA.sch, NewBoardCurrentControl.sch, ThermalControl.sch]
2021-06-18 just added new sheet for butterfly
    [Butterfly.sch, laser.sch]
2021-06-18 add butterfly custom sym
    [ArduinoNano.sch, AtoD_DtoA.sch, Butterfly.sch, NewBoardCurrentControl.sch, NewBoardPowerSupply.sch, PowerOpAmps(TEC Drivers).sch, Reference.sch, ThermalControl.sch]
2021-06-18 TEC on butterfly
    [Butterfly.sch]
2021-06-18 finish monitor on butterfly
    [AtoD_DtoA.sch, Butterfly.sch]
2021-06-18 FINISH Butterfly for QA
    [Butterfly.sch]
2021-06-18 finished butterfly footprint
2021-06-18 assigned butterfly footprint
    [Butterfly.sch]
2021-06-18 add pin numbers to ferrite bead
2021-06-18 fixed footprint for ux60 and 7828
2021-06-18 started pcb layout, confused about pours
    [laser.kicad_pcb]
2021-06-18 added laser.net file
2021-06-18 SOLVED: GND and 4.2V
    [NewBoardCurrentControl.sch, PowerOpAmps(TEC Drivers).sch, laser.kicad_pcb]
2021-06-18 updated the netlist on pcb editor
2021-06-18 changed second 4.2V to GND short in pwropAmps
    [PowerOpAmps(TEC Drivers).sch]
2021-06-19 final push for any last changes 6/18
    [laser.kicad_pcb]
2021-06-21 GND works
    [AtoD_DtoA.sch, laser.kicad_pcb]
2021-06-21 trying to figure out how to connect gnd to plane
    [laser.kicad_pcb]
2021-06-21 connect ground
    [laser.kicad_pcb]
2021-06-21 finished initial layout
    [laser.kicad_pcb]
2021-06-21 laid out reference and current resistors/caps
    [laser.kicad_pcb]
2021-06-21 finish placing power supply
    [laser.kicad_pcb]
2021-06-21 generated new netlist with monitor and ground unshorted
    [laser.kicad_pcb]
2021-06-21 c305 fixing
    [laser.kicad_pcb]
2021-06-21 reload C305 and C306
    [laser.kicad_pcb]
2021-06-21 finished positioning opamps
    [laser.kicad_pcb]
2021-06-21 finish placing thermalcontrol
    [laser.kicad_pcb]
2021-06-21 component placement completed
    [laser.kicad_pcb]
2021-06-22 final edits since Monday
    [laser.kicad_pcb]
2021-06-22 added one reisistor to monitor pin
    [Butterfly.sch]
2021-06-22 connect all opa pads to ground
    [laser.kicad_pcb]
2021-06-22 grounded epad in therm control
    [ThermalControl.sch]
2021-06-22 grounded all other epads
    [NewBoardPowerSupply.sch, PowerOpAmps(TEC Drivers).sch]
2021-06-22 make traces 0.5 mm
    [laser.kicad_pcb]
2021-06-22 grounded epad on pcb
    [laser.kicad_pcb]
2021-06-22 added 5V
    [laser.kicad_pcb]
2021-06-22 update power op amps sch
    [NewBoardPowerSupply.sch, PowerOpAmps(TEC Drivers).sch, ThermalControl.sch, laser.kicad_pcb]
2021-06-22 added 3.3
    [laser.kicad_pcb]
2021-06-22 added half a trace for 5v ext
    [laser.kicad_pcb]
2021-06-22 added grounds, finished 5v ext trace
    [laser.kicad_pcb]
2021-06-22 update netlist from current QA
    [NewBoardCurrentControl.sch, laser.kicad_pcb]
2021-06-22 pb footprint
2021-06-23 added more traces, plus a few grounds. vias on epads as well
    [laser.kicad_pcb]
2021-06-23 connect all grounds? maybe?
    [ArduinoNano.sch, laser.kicad_pcb]
2021-06-23 added one more epad to gnd on current control
    [NewBoardCurrentControl.sch]
2021-06-23 almost done with traces for power supply
    [laser.kicad_pcb]
2021-06-23 All grounds connected, power supply done working on cpu
    [laser.kicad_pcb]
2021-06-23 update sizes on power supply
    [NewBoardCurrentControl.sch, NewBoardPowerSupply.sch, laser.kicad_pcb]
2021-06-24 finished power op amps as well
    [laser.kicad_pcb]
2021-06-24 added other traces at home
    [laser.kicad_pcb]
2021-06-25 finished everything. notes: thick traces, gnd pours, keep outs/pwr plane, DRC Errors
    [ArduinoNano.sch, AtoD_DtoA.sch, Reference.sch, laser.kicad_pcb]
2021-06-25 no more errors in DRC except for th pads
    [laser.kicad_pcb]
2021-06-25 weird airwires
    [ArduinoNano.sch, laser.kicad_pcb]
2021-06-25 COMPLETE for QA
    [laser.kicad_pcb]
2021-06-25 added keepout under cpu
    [laser.kicad_pcb]
2021-06-26 almost done w/ silkscreen
    [laser.kicad_pcb]
2021-06-26 added top copper pour
    [laser-B_Cu.gbr, laser-B_Mask.gbr, laser-B_Paste.gbr, laser-B_SilkS.gbr, laser-Edge_Cuts.gbr, laser-F_Cu.gbr, laser-F_Mask.gbr, laser-F_Paste.gbr]
2021-06-26 finish silkscreen:
    [laser.kicad_pcb]
2021-07-13 enlarge one pad
    [laser.kicad_pcb]
2021-07-14 QA 7/13 added new usb, made pads smaller, qa'd everything except current control, arduino and thermal control
    [ArduinoNano.sch, Butterfly.sch, NewBoardCurrentControl.sch, laser.kicad_pcb]
2021-07-15 final gerber zip added. name is 'ioptis-laser-gerbers-zip'
    [laser-B_Cu.gbl, laser-B_Mask.gbs, laser-B_Paste.gbp, laser-B_SilkS.gbo, laser-Edge_Cuts.gm1, laser-F_Cu.gtl, laser-F_Mask.gts, laser-F_Paste.gtp]
2021-07-23 24pf and got rid of f's
    [ArduinoNano.sch]
2021-07-26 changed silkscreen dot for power op amps
    [laser.kicad_pcb]
2021-08-04 switched butterfly direction, moved capacitors and inductor, flipped 5v external chip to back
    [laser.kicad_pcb]
2021-08-05 NEXT PROTO READY 8/5
    [ArduinoNano.sch, NewBoardPowerSupply.sch, laser.kicad_pcb, laser.sch]
2021-08-06 plotting gerbers for new gen now
    [laser.kicad_pcb]
2021-08-18 new-gen-ioptis-pcb added
    [laser-B_Cu.gbl, laser-B_Mask.gbs, laser-B_Paste.gbp, laser-B_SilkS.gbo, laser-Edge_Cuts.gm1, laser-F_Cu.gtl, laser-F_Mask.gts, laser-F_Paste.gtp]
2021-08-18 restored laer.Kicad
    [laser.kicad_pcb]
2021-09-14 eliminate gnd loops, unground mounting holes except one, move capacitors interfering with case, move LC filters to beginning of 5V, got rid of 5V plane
    [NewBoardPowerSupply.sch, laser.kicad_pcb]
2021-09-15 added ground plane, more vias to minimize ground loops
    [laser.kicad_pcb]
