jisaac2021/IOPTIS-Laser-Controller-Circuit/(notices)

Notices in the files:
laser.kicad_pcb:
Copyright ©
parts and their libraries:
Copyright 2021 Accelerated Designs. All rights reserved.
